Holt-Environments/Prezenz-Q/(threads)

Thread 12 (2022-05-31):

Need 3 more LED channel mosfets

anthonymesa, 2022-05-31:
3 More LED channel mosfets would allow the controll of all colors RGB and W for an LED strip.

Should probably look towards using a generic LED strip, or sourcing a generic 24v LED RGBW so that we aren't stuck on Nexmosphere strips. If we dropped down to 12V I believe the current mosfet model we are using would still work.

Thread 9 (2022-05-31):

Integrate better message passing algorithm.

anthonymesa, 2022-05-31:
Currently sending messages in the format '[ A 0x00 ]' or '[ B 0x01 ]' is okay, but it is limited to 26 available command ID's and 255 commands without any arguments. I would like to make this message passing more robust, allowing for variable-length messages to be passed, but this almost requires creating a whole protocol with regexing, and things like that.

While I can do this, I am not focused on it right now because the current implementation works, though could be at a higher chance of being prone to error.
