Holt-Environments/Prezenz-Q/Controller/Schematics/conmet.kicad_sch

## KiCad design Controller/Schematics/conmet.kicad_sch (2022-05-31, an earlier design)

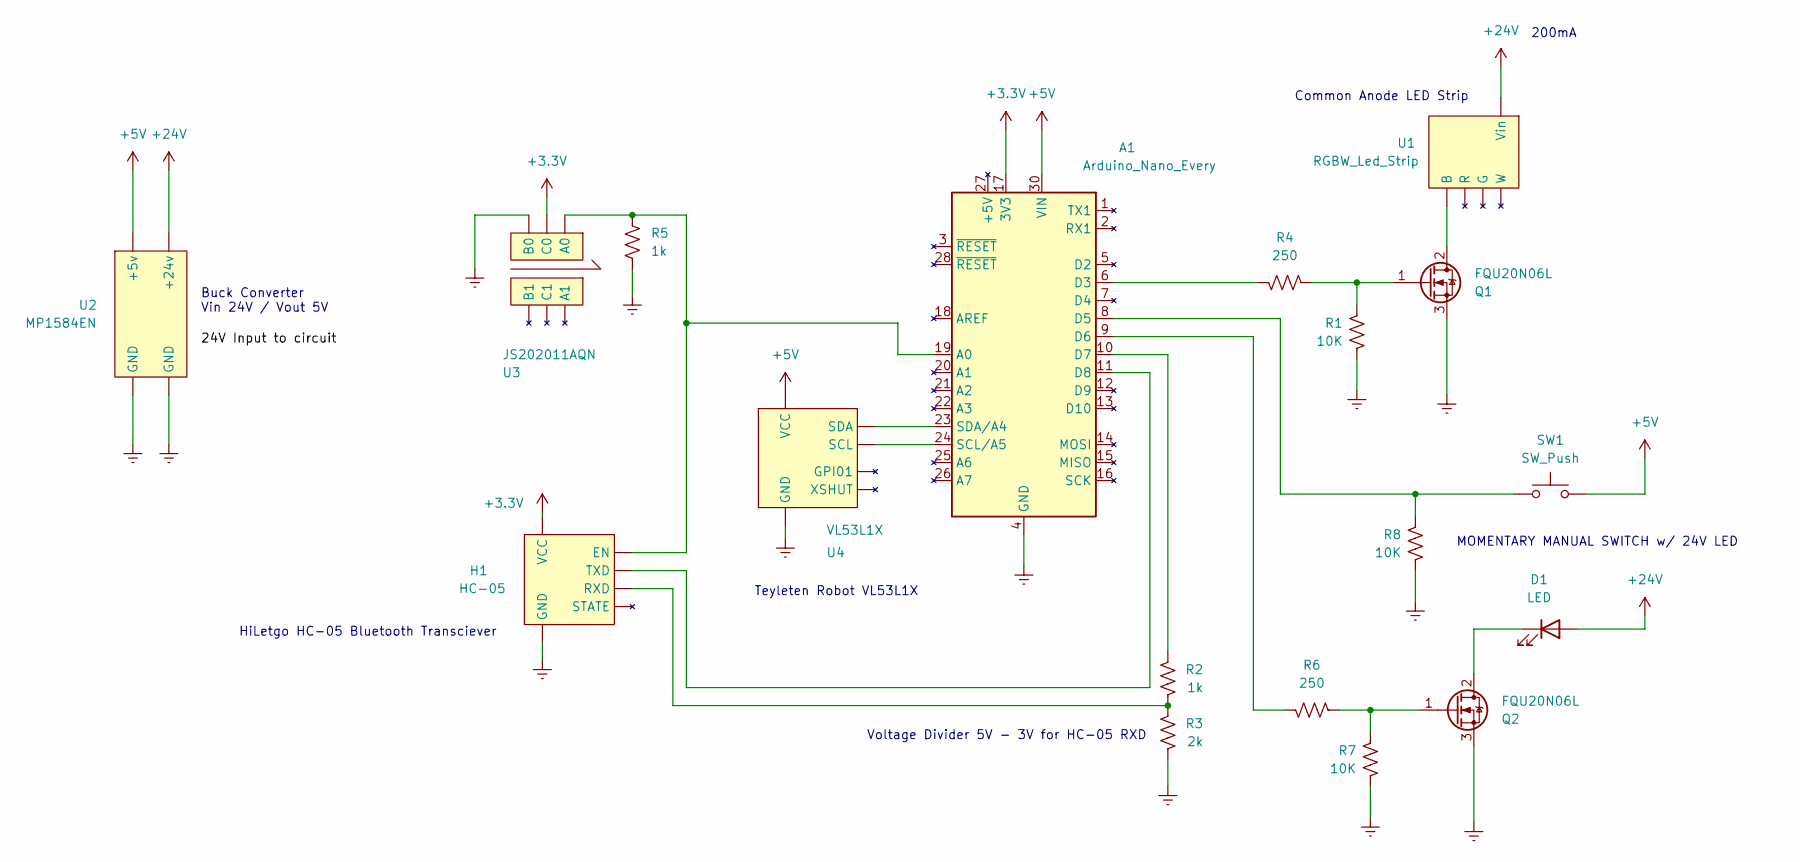
[picture p1: schematic conmet.kicad_sch]

Parts:
A1: Arduino_Nano_Every; Arduino_Nano
D1: LED
H1: HC-05
Q1, Q2: FQU20N06L
R1, R7, R8: 10K
R2, R5: 1k
R3: 2k
R4, R6: 250
SW1: SW_Push
U1: RGBW_Led_Strip
U2: MP1584EN
U3: JS202011AQN
U4: VL53L1X

Connections:
+3.3V: A1.17 (3V3), H1., U3.
+5V: A1.30 (VIN), SW1.2, U2., U4.
+24V: D1.2 (A), U1., U2.
Earth: A1.4 (GND), A1.29 (GND), H1., Q1.3 (S), Q2.3 (S), R1.1, R3.2, R5.2, R7.1, R8.1, U2., U3., U4.
unnamed: A1.6 (D3), R4.2
unnamed: A1.8 (D5), R8.2, SW1.1
unnamed: A1.9 (D6), R6.2
unnamed: A1.10 (D7), R2.2
unnamed: A1.11 (D8), H1.
unnamed: A1.19 (A0), H1., R5.1, U3.
unnamed: A1.23 (SDA/A4), U4.
unnamed: A1.24 (SCL/A5), U4.
unnamed: D1.1 (K), Q2.2 (D)
unnamed: H1., R2.1, R3.1
unnamed: Q1.1 (G), R1.2, R4.1
unnamed: Q1.2 (D), U1.
unnamed: Q2.1 (G), R6.1, R7.2

Notes on the sheet:
Buck Converter Vin 24V / Vout 5V
MOMENTARY MANUAL SWITCH w/ 24V LED
200mA
Teyleten Robot VL53L1X
Voltage Divider 5V - 3V for HC-05 RXD
Common Anode LED Strip
HiLetgo HC-05 Bluetooth Transciever
