Holt-Environments/Prezenz-Q/Queue/Windows x64/src/main.cpp

#include "ofMain.h"
#include "ofApp.h"

//========================================================================
int main( ){
	ofSetupOpenGL(1920,1152,OF_WINDOW);			// <-------- setup the GL context

	// this kicks off the running of my app
	// can be OF_WINDOW or OF_FULLSCREEN
	// pass in width and height too:
	ofRunApp(new ofApp());

}
