Holt-Environments/Prezenz-Q/Controller/Current (Arduino IDE)/prezenzq/prezenzq.h

/**
   =======================================================================
   PrezenzQ Controller - prezenzq.h

   Holt Environments
   Author: Anthony Mesa
   Date: 05/24/2022

   prezenzq.h defines the values that are specific to the Arduino itself.

   =======================================================================
*/

#ifndef ARDUINO_LIB
#define ARDUINO_LIB
#include <Arduino.h>
#endif

#define ARDUINO_LED 13
#define ARDUINO_SERIAL_BAUD 9600
