Holt-Environments/Prezenz-Q/(commit log)

2022-02-07 added schematic files
    [conmet.kicad_pcb, conmet.kicad_sch]
2022-02-16 Fixed erroneous values in sensors and made video queue full screen
    [arduino_nano.ino, main.cpp, ofApp.cpp]
2022-02-18 fixed plinth flashing jitter and enabled state setting on failed sensor reading
    [arduino_nano.ino]
2022-02-19 refactoring LedDriver
2022-02-21 finished LedDriver
2022-02-24 fixed led sin function
    [LedDriver.cpp, prezenzq_controller.ino]
2022-02-25 fixed led and tof
    [LedDriver.cpp, LedDriver.h, TofSensor.cpp, TofSensor.h, prezenzq_controller.ino]
2022-03-02 trying to fix TOF initialization issue
    [HC05Driver.cpp, HC05Driver.h, TofSensor.cpp, prezenzq_controller.ino]
2022-05-20 added button code to controller (no sensor only)
    [conmet.kicad_sch]
2022-05-24 added button logic
2022-05-27 updating schmeatics with pcb layout
    [conmet.kicad_sch]
